Polarren/ECE445/Datasheets/STM32F103C8T6核心板(1)/串口下载教程/STM32串口软件画面.jpg

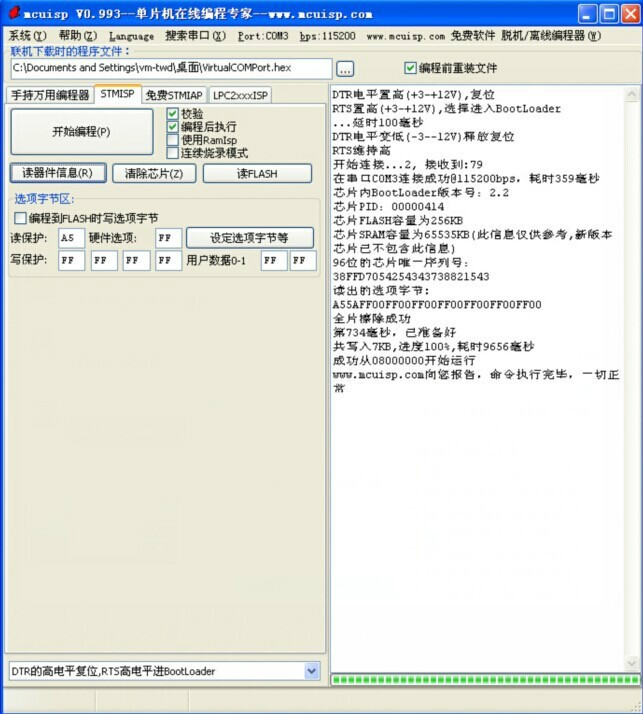
Datasheets/STM32F103C8T6核心板(1)/串口下载教程/STM32串口软件画面.jpg
