Polarren/ECE445/ADProject/BOM.xlsx

Comment | Description | Designator | Footprint | LibRef | Quantity
1575R-A |  | J? |  | 1575R-A | 1
Res2 | Resistor | R? | AXIAL-0.4 | Res2 | 6
18650 |  | U? |  | 18650 | 1
ATGM336H |  | U? |  | ATGM336H | 1
BME680 |  | U? |  | BME680 | 1
esp01 |  | U? |  | esp01 | 1
MiCS-6814 |  | U? |  | MiCS-6814 | 1
PMS5003 |  | U? |  | PMS5003 | 1
STM32_Dev |  | U? |  | STM32_Dev | 1
