Polarren/ECE445/(list of files, cad)

Other CAD files:
Shell/侧板.dwg
Shell/顶层.dwg
Shell/支架.dwg
Shell/底盘.dwg
Shell/百叶.dwg
