Polarren/ECE445/ADProject/Schematics_0401.pdf

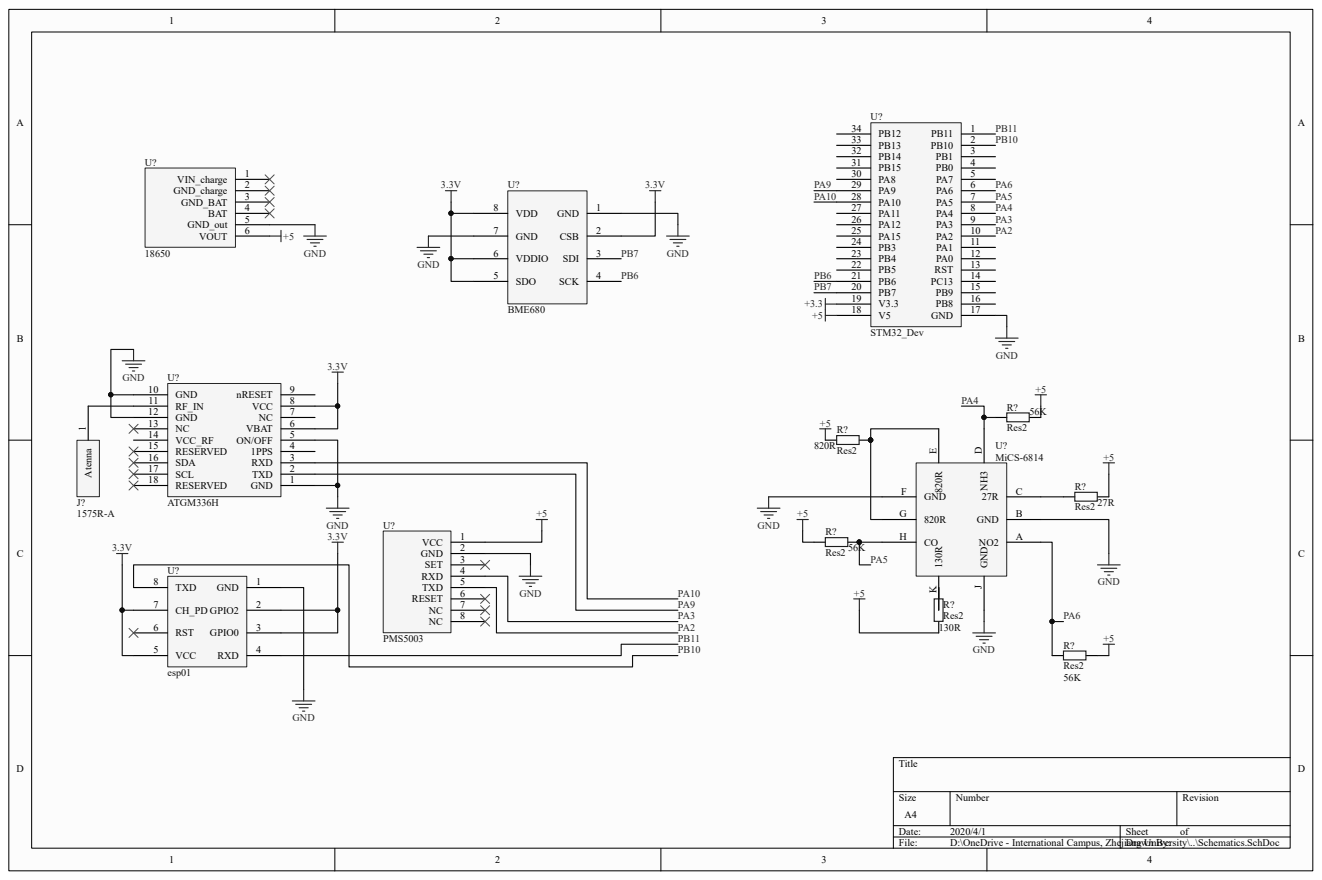
[picture p18: page 1]
Title; Size; Number; Revision; Date:; Sheet; File:; D:\OneDrive - International Campus, Zhejiang University\..\Schematics.SchDoc Drawn By:; RST; GND; STM32_Dev; VIN_charge; GND_charge; GND_BAT; BAT; GND_out; VOUT; TXD; RXD; 1PPS; ON/OFF; VBAT; VCC; nRESET; 9 GND 10; RF_IN 11 GND 12 NC 13 VCC_RF 14 RESERVED 15 SDA 16 SCL 17 RESERVED 18; ATGM336H; GPIO2; GPIO0; 4 VCC 5; RST 6; TXD 8; esp01; SET; RESET; PMS5003; +5 Atenna 1; C NH³ D 820R; GND F; U? MiCS-6814; Res2; R? Res2; CSB; SDI; SCK; 4 SDO 5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
