Polarren/ECE445/ADProject/Schematics_0325.pdf

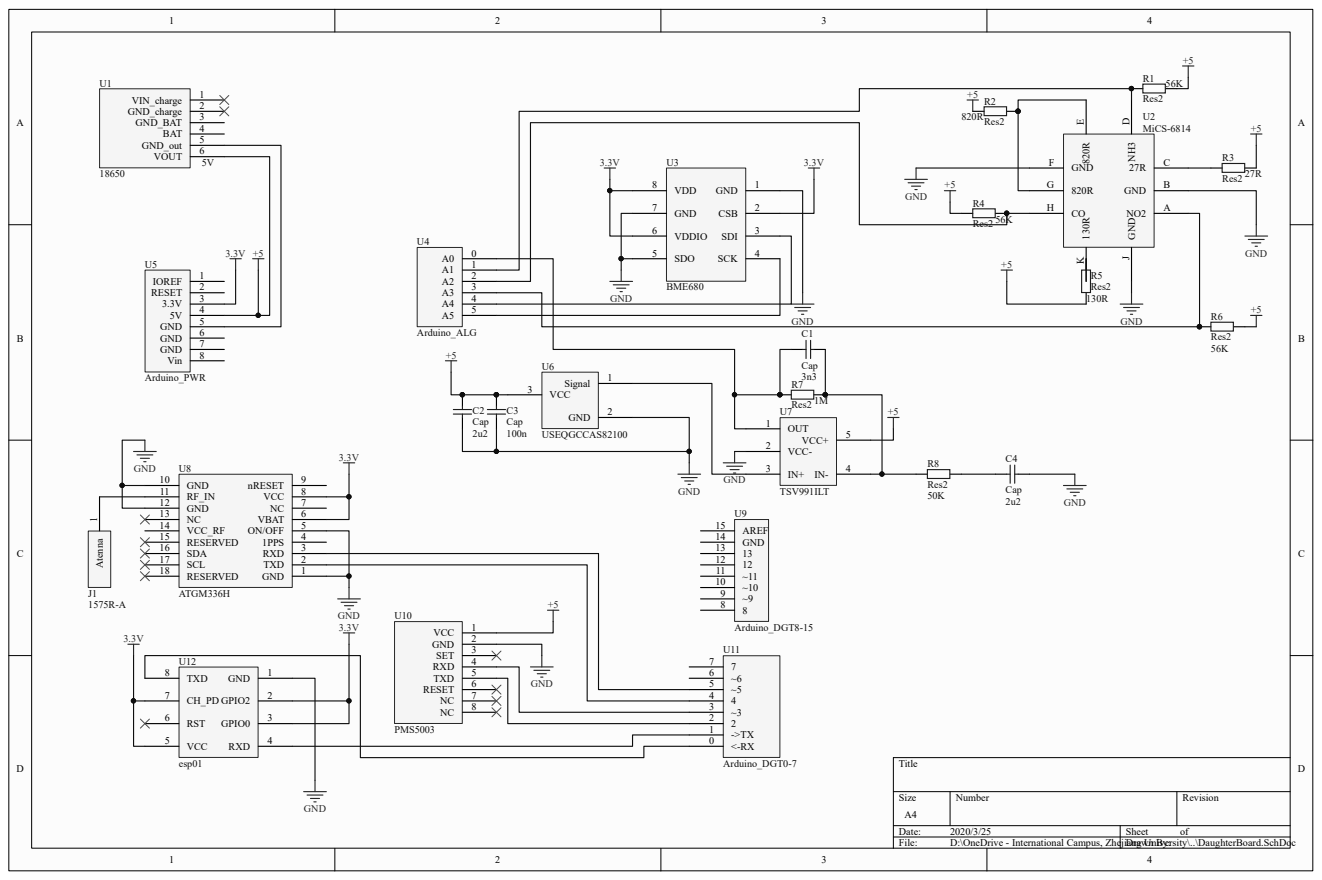
[picture p19: page 1]
