Polarren/ECE445/ADProject/Schematics_04012208.pdf

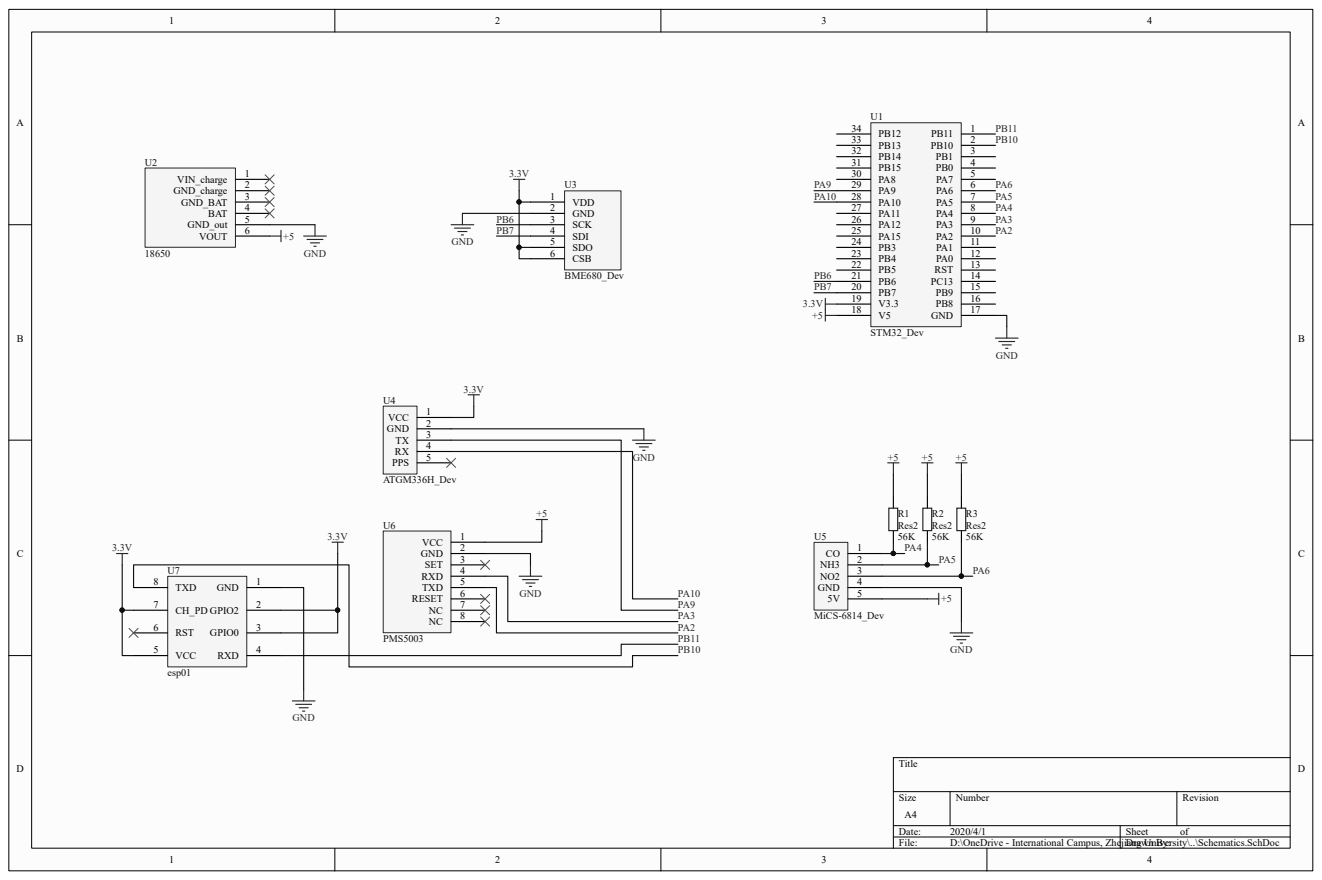
[picture p20: page 1]
