Polarren/ECE445/(list of files, drawings)

Other design files:
ADProject/DaughterBoard.PcbDoc
ADProject/DaughterBoard.SchDoc
ADProject/PCB.PcbDoc
ADProject/PCB_old.PcbDoc
ADProject/Project.PrjPCB
ADProject/Schematics.SchDoc
ADProject/SDLib.PcbLib
ADProject/SDLib.SchLib
ADProject/STM32F103C8T6核心板-外形尺寸.PcbDoc
ADProject/STM32F103C8T6核心板封装库.PcbLib
ADProject/Switch.SchDoc
Datasheets/STM32F103C8T6核心板(1)/原理图 尺寸外框 封装库/STM32F103C8T6核心板-外形尺寸.PcbDoc
Datasheets/STM32F103C8T6核心板(1)/原理图 尺寸外框 封装库/STM32F103C8T6核心板封装库.PcbLib
PCB_Assignment/PcbAssignment.PcbDoc
PCB_Assignment/PcbAssignment.PrjPCB
PCB_Assignment/PcbAssignment.SchDoc
PCB_Assignment/PcbAssignmentLib.PcbLib
PCB_Assignment/PcbAssignmentLib.SchLib
