Polarren/ECE445/(notices)

Notices in the files:
parts and their libraries:
Arduino-utility: Copyright (c) 2016-2017 Arduino LLC. All right reserved.
